lfochamon/memsarray/README.md

# MEMSArray: A prototype MEMS microphone array for the BeagleBone Black

This repository contains a prototype MEMS microphone array cape for the BBB.
