lfochamon/memsarray/Hardware/array/mems_array.kicad_pcb

## KiCad design Hardware/array/mems_array.kicad_pcb (2016-03-04)

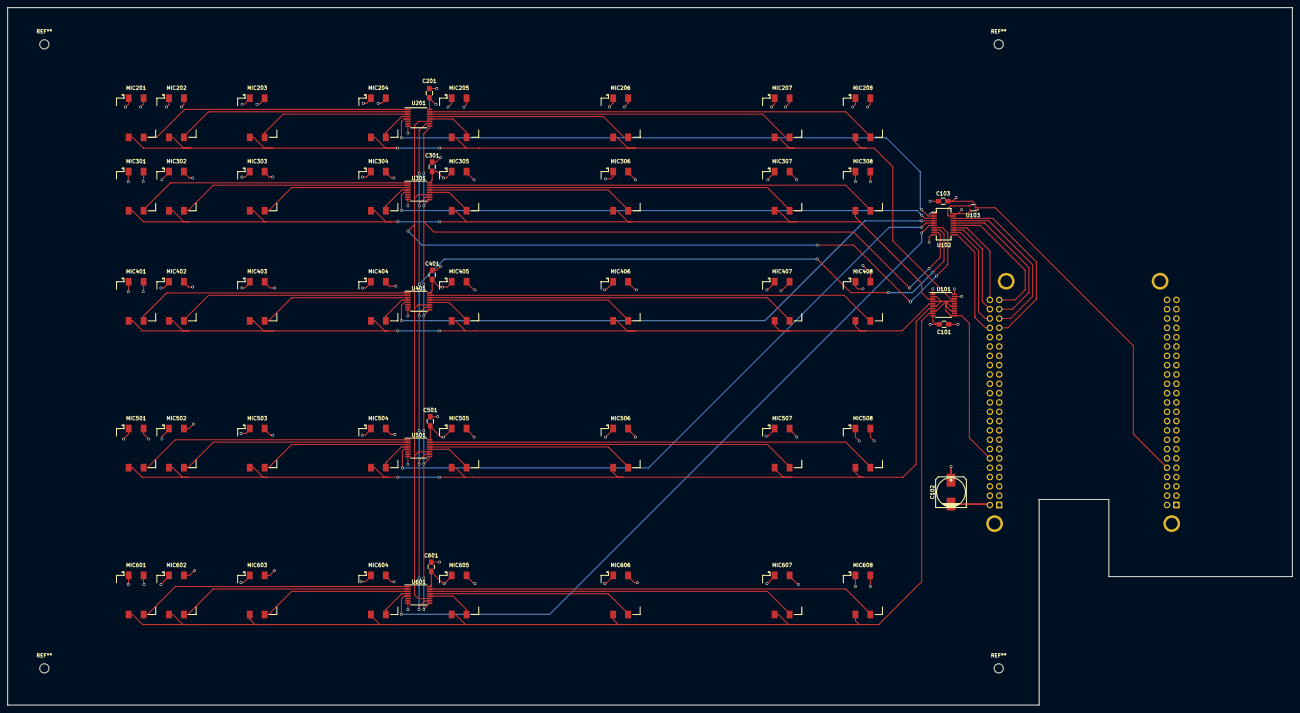
[picture p1: board mems_array.kicad_pcb from above]

Board: 4 copper layers, 350.0 x 190.0 mm, 57 parts (1 on the bottom side), 66 nets.

Parts:
C101, C103, C201, C301, C401, C501, C601: 1uF; C_0805_HandSoldering
C102: 100uF; c_elec_8x10
MIC201, MIC202, MIC203, MIC204, MIC205, MIC206, MIC207, MIC208, MIC301, MIC302, MIC303, MIC304, MIC305, MIC306, MIC307, MIC308, MIC401, MIC402, MIC403, MIC404, MIC405, MIC406, MIC407, MIC408, MIC501, MIC502, MIC503, MIC504, MIC505, MIC506, MIC507, MIC508, MIC601, MIC602, MIC603, MIC604, MIC605, MIC606, MIC607, MIC608: MIC_MODULE; Mems_Mic_Module
U101: 74AHC244; TSSOP-20_4.4x6.5mm_Pitch0.65mm
U102: 743245; SOP-20_600x175_Pitch0.635
U103: 741G04; SOTFL-5_160x50_Pitch0.5
U104: BEAGLEBONEBLACK; beagleboneblack
U201, U301, U401, U501, U601: SN74CTBLV3251; TSSOP-16_4.4x5mm_Pitch0.65mm

Connections:
/Microphone set A/CLK: MIC201.4, MIC202.4, MIC203.4, MIC204.4, MIC205.4, MIC206.4, MIC207.4, MIC208.4, U101.18
/Microphone set A/OUT: U102.2, U201.5
/Microphone set A/S0: U102.7, U201.11, U301.11, U401.11, U501.11, U601.11
/Microphone set A/S1: U102.8, U201.10, U301.10, U401.10, U501.10, U601.10
/Microphone set A/S2: U102.9, U201.9, U301.9, U401.9, U501.9, U601.9
/Microphone set B/CLK: MIC301.4, MIC302.4, MIC303.4, MIC304.4, MIC305.4, MIC306.4, MIC307.4, MIC308.4, U101.3
/Microphone set B/OUT: U102.3, U301.5
/Microphone set C/CLK: MIC401.4, MIC402.4, MIC403.4, MIC404.4, MIC405.4, MIC406.4, MIC407.4, MIC408.4, U101.5
/Microphone set C/OUT: U102.4, U401.5
/Microphone set D/CLK: MIC501.4, MIC502.4, MIC503.4, MIC504.4, MIC505.4, MIC506.4, MIC507.4, MIC508.4, U101.7
/Microphone set D/OUT: U102.5, U501.5
/Microphone set E/CLK: MIC601.4, MIC602.4, MIC603.4, MIC604.4, MIC605.4, MIC606.4, MIC607.4, MIC608.4, U101.9
/Microphone set E/OUT: U102.6, U601.5
/PRU0_15: U101.2, U101.4, U101.6, U101.8, U101.11, U101.13, U101.15, U101.17, U104.B12
/PRU1_0: U102.15, U104.B45
/PRU1_1: U102.14, U104.B46
/PRU1_2: U102.16, U104.B43
/PRU1_3: U102.13, U104.B44
/PRU1_4: U102.17, U104.B41
/PRU1_5: U102.12, U104.B42
/PRU1_6: U102.18, U104.B39
/PRU1_7: U102.11, U104.B40
/SYS_RESETn: U103.2, U104.C10
DGND: C101.2, C102.2, C103.2, C201.2, C301.2, C401.2, C501.2, C601.2, MIC201.2, MIC202.2, MIC203.2, MIC204.2, MIC205.2, MIC206.2, MIC207.2, MIC208.2, MIC301.2, MIC302.2, MIC303.2, MIC304.2, MIC305.2, MIC306.2, MIC307.2, MIC308.2, MIC401.2, MIC402.2, MIC403.2, MIC404.2, MIC405.2, MIC406.2, MIC407.2, MIC408.2, MIC501.2, MIC502.2, MIC503.2, MIC504.2, MIC505.2, MIC506.2, MIC507.2, MIC508.2, MIC601.2, MIC602.2, MIC603.2, MIC604.2, MIC605.2, MIC606.2, MIC607.2, MIC608.2, U101.1, U101.10, U101.19, U102.10, U103.3, U104.B1, U104.B2, U104.C1, U104.C2, U104.C43, U104.C44, U104.C45, U104.C46, U201.7, U201.8, U301.7, U301.8, U401.7, U401.8, U501.7, U501.8, U601.7, U601.8
DVDD: C101.1, C102.1, C103.1, C201.1, C301.1, C401.1, C501.1, C601.1, MIC201.1, MIC202.1, MIC203.1, MIC204.1, MIC205.1, MIC206.1, MIC207.1, MIC208.1, MIC301.1, MIC302.1, MIC303.1, MIC304.1, MIC305.1, MIC306.1, MIC307.1, MIC308.1, MIC401.1, MIC402.1, MIC403.1, MIC404.1, MIC405.1, MIC406.1, MIC407.1, MIC408.1, MIC501.1, MIC502.1, MIC503.1, MIC504.1, MIC505.1, MIC506.1, MIC507.1, MIC508.1, MIC601.1, MIC602.1, MIC603.1, MIC604.1, MIC605.1, MIC606.1, MIC607.1, MIC608.1, U101.20, U102.20, U103.5, U104.C3, U104.C4, U201.16, U301.16, U401.16, U501.16, U601.16
unnamed: MIC201.3, U201.1
unnamed: MIC202.3, U201.2
unnamed: MIC203.3, U201.3
unnamed: MIC204.3, U201.4
unnamed: MIC205.3, U201.12
unnamed: MIC206.3, U201.13
unnamed: MIC207.3, U201.14
unnamed: MIC208.3, U201.15
unnamed: MIC301.3, U301.1
unnamed: MIC302.3, U301.2
unnamed: MIC303.3, U301.3
unnamed: MIC304.3, U301.4
unnamed: MIC305.3, U301.12
unnamed: MIC306.3, U301.13
unnamed: MIC307.3, U301.14
unnamed: MIC308.3, U301.15
unnamed: MIC401.3, U401.1
unnamed: MIC402.3, U401.2
unnamed: MIC403.3, U401.3
unnamed: MIC404.3, U401.4
unnamed: MIC405.3, U401.12
unnamed: MIC406.3, U401.13
unnamed: MIC407.3, U401.14
unnamed: MIC408.3, U401.15
unnamed: MIC501.3, U501.1
unnamed: MIC502.3, U501.2
unnamed: MIC503.3, U501.3
unnamed: MIC504.3, U501.4
unnamed: MIC505.3, U501.12
unnamed: MIC506.3, U501.13
unnamed: MIC507.3, U501.14
unnamed: MIC508.3, U501.15
unnamed: MIC601.3, U601.1
unnamed: MIC602.3, U601.2
unnamed: MIC603.3, U601.3
unnamed: MIC604.3, U601.4
unnamed: MIC605.3, U601.12
unnamed: MIC606.3, U601.13
unnamed: MIC607.3, U601.14
unnamed: MIC608.3, U601.15
unnamed: U102.19, U103.4
