lfochamon/memsarray/Hardware/modules/mems_modules.kicad_pcb

## KiCad design Hardware/modules/mems_modules.kicad_pcb (2015-12-19)

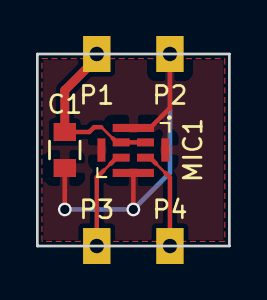
[picture p2: board mems_modules.kicad_pcb from above]

Board: 2 copper layers, 10.7 x 10.7 mm, 6 parts (0 on the bottom side), 4 nets.

Parts:
C1: 1uF; C_0805
MIC1: MEMS_MIC; Mic-MEMS_Top_8_pins
P1, P2, P3, P4: CASTELLATED_PAD; Castellated_Pad

Connections:
/CLK: MIC1.3, P3.1
/OUT: MIC1.4, P4.1
DGND: C1.2, MIC1.5, P2.1
DVDD: C1.1, MIC1.1, MIC1.2, P1.1
