lfochamon/memsarray/(commit log)

2015-07-03 Fix message sizes and number of buffer to TX/RX.
    [main.c]
2015-07-03 Fix input pins definitions in DTO.
    Input pins should not use pull up/down resistors so that the line value does not change value while the mic output is tristated.
2015-07-07 Acquire mic value after falling edge.
    The array is constructed so that L/R select is tied to GND, i.e., so that all mics are DATA1 and push their value on the falling edge of the clock instead of the rising edge.
2015-07-15 Remove socket code: only save results to local file.
2015-07-15 Remove remaining references to socket code.
2015-07-15 Measure and fix clock timing.
    [mems_pru1.asm]
2015-07-16 Add trace messages throughout program execution.
2015-07-16 Clean up code and fix coding standards.
    [main.c]
2015-12-18 First commit.
    [mems_array.kicad_pcb, mems_array.sch, mems_modules.kicad_pcb, mems_modules.sch]
2015-12-19 Schematic for the MEMS microphone module.
    [mems_modules.sch]
2015-12-19 Add footprint for castellated pad.
2015-12-19 Generate netlist for PCB.
2015-12-19 Update hole size of castellated pad footprint.
    [mems_modules.sch]
2015-12-19 Create PCB of MEMS microphone module.
    [mems_modules.kicad_pcb]
2015-12-19 Reduce MEMS mic module.
    [mems_modules.kicad_pcb]
2015-12-20 Move footprint library to top folder.
2015-12-20 Add MEMS microphone module footprint.
2015-12-20 Fix footprint library path.
2015-12-20 Design schematic for the array.
    [mems_array.sch, mic_row.sch]
2015-12-21 Change all power pin types to "Power input".
2015-12-21 Annotate and fix ERC errors.
    [mems_array.sch, mic_row.sch]
2015-12-21 Add footprints to schematics and generate new netlist.
    [mems_array.sch, mic_row.sch]
2015-12-22 Design array PCB.
    - Several fixes in the schematics to improve pin use and routing.
    - Added 2 power plane layers. Stack up is Signal-GND-VDD-Signal.
    - Missing lib documentation file (.dcm).
    [mems_array.kicad_pcb, mems_array.sch, mic_row.sch]
2015-12-22 Fix PCB position in the page.
    [mems_array.kicad_pcb]
2016-02-21 Move hardware files to /Hardware folder.
    [mems_array.kicad_pcb, mems_array.sch, mems_modules.kicad_pcb, mems_modules.sch, mic_row.sch]
2016-03-04 Fix unconnected pins.
    [mems_array.kicad_pcb]
